Lafayette-FSAE/KiCad-TSI/Circuit_layout.kicad_pcb

## KiCad design Circuit_layout.kicad_pcb (2020-02-18)

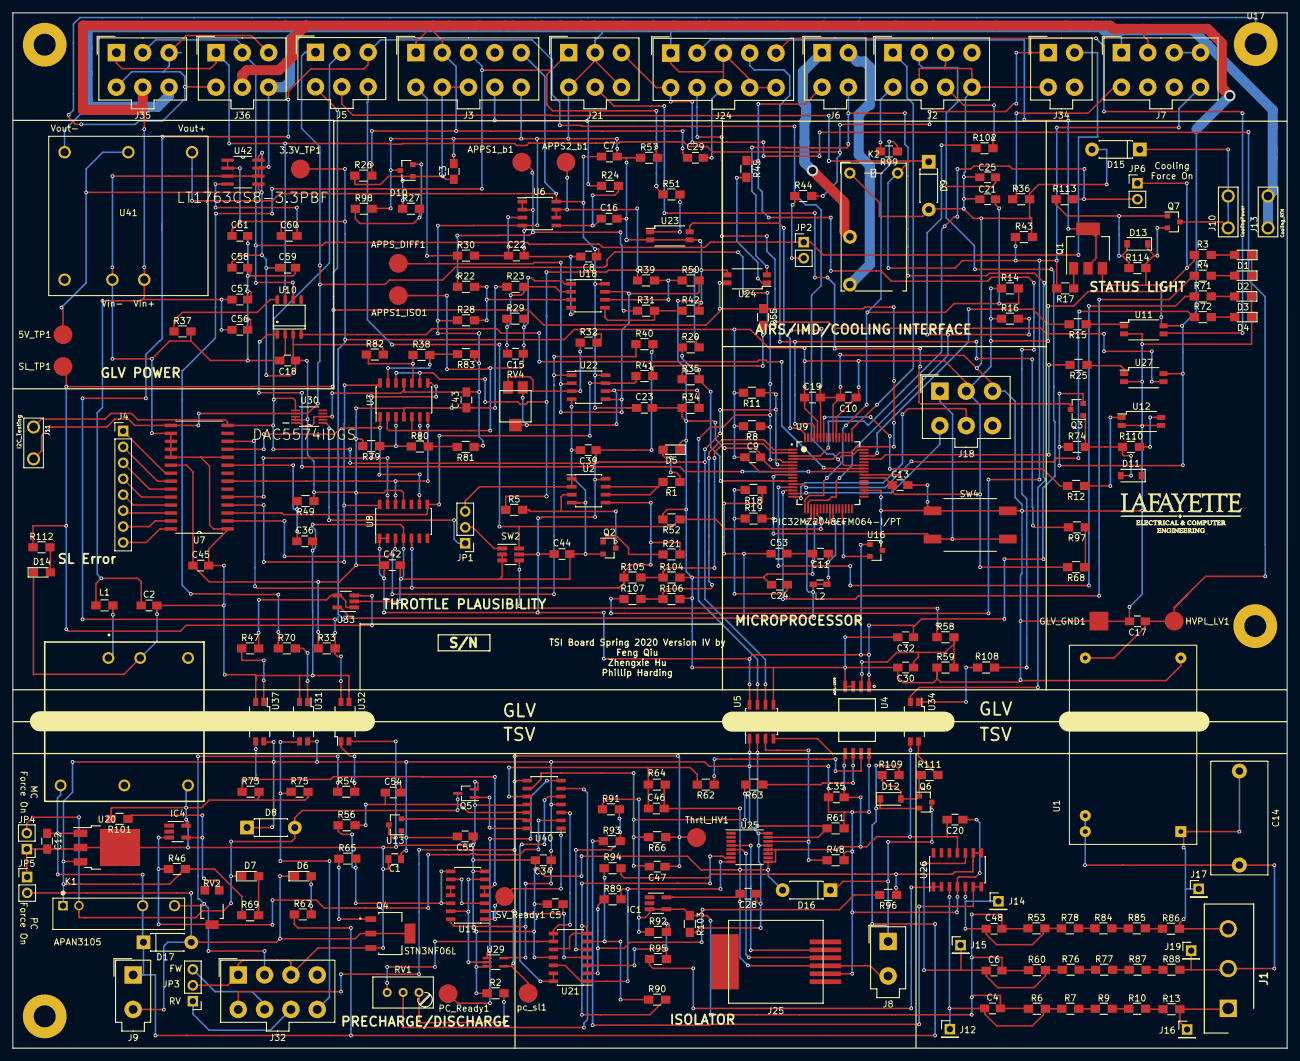
[picture p1: board Circuit_layout.kicad_pcb from above]

Board: 2 copper layers, 203.2 x 165.1 mm, 281 parts (0 on the bottom side), 185 nets.

Parts:
3.3V_TP1: 3.3V_TP; Measurement_Point_Round-SMD-Pad_Big
5V_TP1: 5V_TP; Measurement_Point_Round-SMD-Pad_Big
APPS1_ISO1: APPS1_ISO; Measurement_Point_Round-SMD-Pad_Big
APPS1_b1: APPS1_b; Measurement_Point_Round-SMD-Pad_Big
APPS2_b1: APPS2_b; Measurement_Point_Round-SMD-Pad_Big
APPS_DIFF1: APPS_DIFF; Measurement_Point_Round-SMD-Pad_Big
C1: 0.47u; C_0805
C2, C17: 4.7u; C_0805_HandSoldering
C3, C5, C7, C8, C9, C10, C11, C13, C15, C16, C18, C19, C20, C21, C22, C23, C25, C28, C29, C32, C34, C35, C39, C42, C43, C44, C45, C53, C55, C58: 0.1u; C_0805_HandSoldering
C4, C6, C30, C46, C47, C48: 100p; C_0805_HandSoldering
C12: 0.33u; C_0805_HandSoldering
C14: 1u; C_Rect_L18.0mm_W9.0mm_P15.00mm_FKS3_FKP3
C24: 0.1uF; C_0805_HandSoldering
C36: 33p; C_0805_HandSoldering
C54: 15u; C_0805_HandSoldering
C56, C57, C61: 10u; C_0805_HandSoldering
C59, C60: 1u; C_0805_HandSoldering
D1: Power; LED_0805_HandSoldering
D2: Heartbeat; LED_0805_HandSoldering
D3: Spare/Fault; LED_0805_HandSoldering
D4: Spare; LED_0805_HandSoldering
D5: Throttle_PL; LED_0805_HandSoldering
D6, D7: LED; LED_0805_HandSoldering
D8, D9, D15, D16, D17: 1N4001; D_DO-41_SOD81_P7.62mm_Horizontal
D10: ATL431; SOT-23_D10_special
D11, D12, D13: MMSZ5231B-7-F; D_SOD-123
D14: SL Error; LED_0805_HandSoldering
GLV_GND1: GLV_GND; Measurement_Point_Square-SMD-Pad_Big
HVPL_LV1: TSAL_LV; Measurement_Point_Round-SMD-Pad_Big
IC1, IC4: TS431ILT; SOT-23-5_HandSoldering
J1: TSV; SHDR3W166P0X635_1X3_2032X762X1422P
J2: CoolingSystem; Molex_MiniFit-JR-5556-08A_2x04x4.20mm_Straight
J3: Pedal; Molex_MiniFit-JR-5556-10A_2x05x4.20mm_Straight
J4: Conn_01x08; Pin_Header_Straight_1x08_Pitch2.54mm
J5: Testing Connector; Molex_MiniFit-JR-5556-06A_2x03x4.20mm_Straight
J6: AIRs/SafetyLoop; Molex_MiniFit-JR-5556-04A_2x02x4.20mm_Straight
J7: IMD; Molex_MiniFit-JR-5556-08A_2x04x4.20mm_Straight
J8: DC_Relay; Molex_MiniFit-JR-5556-02A_2x01x4.20mm_Straight
J9: PC_Relay; Molex_MiniFit-JR-5556-02A_2x01x4.20mm_Straight
J10: CoolingPower; TE_1217861-1
J11: I2C_Testing; TE_1217861-1
J12, J14, J15, J16, J17, J19: Conn_01x01; Pin_Header_Straight_1x01_Pitch2.54mm
J13: Cooling_RTN; TE_1217861-1
J18: ICSP; Molex_MiniFit-JR-5556-06A_2x03x4.20mm_Straight
J21: Lights On Car; Molex_MiniFit-JR-5556-06A_2x03x4.20mm_Straight
J24: Cockpit; Molex_MiniFit-JR-5556-10A_2x05x4.20mm_Straight
J25: RJ11; MOLEX_RJ11
J32: Conn_MC; Molex_MiniFit-JR-5556-08A_2x04x4.20mm_Straight
J34: Can_Iso; Molex_MiniFit-JR-5556-04A_2x02x4.20mm_Straight
J35: GLV_In; Molex_MiniFit-JR-5556-06A_2x03x4.20mm_Straight
J36: GLV_Out; Molex_MiniFit-JR-5556-06A_2x03x4.20mm_Straight
JP1, JP3: Jumper_NC_Dual; Pin_Header_Straight_1x03_Pitch2.54mm
JP2, JP6: Jumper; Pin_Header_Straight_1x02_Pitch2.54mm
JP4, JP5: Jumper-Device; Pin_Header_Straight_1x02_Pitch2.54mm
K1: APAN3105; RELAY_APAN3105
K2: G6B-1174P-US-DC24; Relay_SPST_Finder_32.21-x300_special
L1: 2.2uH; L_0805_HandSoldering
L2: 28nH; L_0603_HandSoldering
PC_Ready1: Precharge_Ready; Measurement_Point_Round-SMD-Pad_Big
PS1: THN_30-2415WI; THN_30
Q1: ZVP0545G; SOT-223-3_TabPin2
Q2: MMBF170; SOT-23
Q3, Q6, Q7: ZVP1320F; SOT-23
Q4: STN3NF06L; SOT230P700X180-4N-speical
Q5: SI1302DL-T1-E3; SOT-323_SC-70_Handsoldering_special
R1, R47, R69, R105, R106: 500; R_0805_HandSoldering
R2: 95k; R_0805_HandSoldering
R3, R4, R71, R72, R112: 330; R_0805_HandSoldering
R5, R6, R8, R11, R14, R16, R17, R18, R21, R22, R23, R28, R29, R31, R39, R40, R41, R42, R48, R50, R52, R53, R59, R60, R61, R62, R63, R68, R89, R90, R91, R92, R93, R94, R95, R96, R97, R101, R110, R111, R113: 10k; R_0805_HandSoldering
R7, R9, R10, R13, R76, R77, R78, R84, R85, R86, R87, R88: 150k; R_0805_HandSoldering
R12, R15, R25: 300; R_0805_HandSoldering
R19, R37, R46, R103, R104: 1k; R_0805_HandSoldering
R20: 2k; R_0805_HandSoldering
R24, R30, R57: 100k; R_0805_HandSoldering
R26: 1K; R_0805_HandSoldering
R27, R98: 10K; R_0805_HandSoldering
R32, R34: 4k; R_0805_HandSoldering
R33, R73, R75: 5k; R_0805_HandSoldering
R35, R107: 3k; R_0805_HandSoldering
R36, R43: 2.2k; R_0805_HandSoldering
R38, R80: 9.31k; R_0805_HandSoldering
R44: 120; R_0805_HandSoldering
R45, R51, R54, R55, R67, R70, R108: 2.4k; R_0805_HandSoldering
R49: 3.9K; R_0805_HandSoldering
R56: 56K; R_0805_HandSoldering
R58: 15k; R_0805_HandSoldering
R64, R66: 24.9k; R_0805_HandSoldering
R65: 5K; R_0805_HandSoldering
R74, R109, R114: 1M; R_0805_HandSoldering
R79, R81, R82, R83: 499; R_0805_HandSoldering
R99, R102: 1.6k; R_0805_HandSoldering
RV1: 3296W-1-103LF; Potentiometer_Trimmer_Bourns_3296W
RV2: POT_TRIM; 23BR10KLFTR
RV4: 1k; trim_pot
SL_TP1: SL_TP; Measurement_Point_Round-SMD-Pad_Big
SW2: TS5A3159-Q1; SOT-23-6_Handsoldering
SW4: SW_PUSH; SW_RACON_8
TSV_Ready1: TSV_Ready; Measurement_Point_Round-SMD-Pad_Big
Thrtl_HV1: Throttle_HV; Measurement_Point_Round-SMD-Pad_Big
U1: RDE03110S12; RDE03110S12_new
U2: MCP6002; SOIC-8_3.9x4.9mm_Pitch1.27mm
U3, U21, U26, U40: MCP6004; SOIC-14_3.9x8.7mm_Pitch1.27mm
U4: ACPL-C870; SOIC127P1150X360-8N
U5: SI8600AB-B-IS; SOIC-8_3.9x4.9mm_Pitch1.27mm
U6, U18: TS912; SOIC-8_3.9x4.9mm_Pitch1.27mm
U7: MCP23016; SOIC127P1030X265-28N
U8: 74ACT11030; SOIC-14_3.9x8.7mm_Pitch1.27mm
U9: PIC32MZ2048EFM064-I/PT; QFP50P1200X1200X120-64N
U10: MCP2551-I/SN; SO-8
U11, U12, U23, U24, U27, U31, U32, U34, U37: TLP293; SOP-4_4.4x2.8mm_Pitch1.27mm
U13: REF3033; SOT-23
U14, U15, U28: Mounting_hole; MountingHole_3.5mm_Pad
U16: MCP9700AT-H/TT; SOT-23
U17: Chassis Ground; MountingHole_3.5mm_Pad
U19: 74HC00; SOIC-14_3.9x8.7mm_Pitch1.27mm
U20: MC7805BDTRKG; TO-252-3_TabPin4
U22: TS372; SOIC-8_3.9x4.9mm_Pitch1.27mm
U25: NCD9830DBR2G; TSSOP-16_4.4x5mm_Pitch0.65mm
U29: SN74LVC1G08DCKR; SOT-353_SC-70-5_Handsoldering
U30: DAC5574IDGS; SOP50P490X110-10N
U33: MCP6001; SOT-23-5_HandSoldering
U41: PDQ10-Q24-D5-D; PDQ_DCDC
U42: LT1763CS8-3.3PBF; SOIC127P600X175-8N
pc_sl1: pc_sl; Measurement_Point_Round-SMD-Pad_Big

Connections:
/+1.24Vref: IC4.3, R46.1, RV2.2, U40.2
/+3.3V: 3.3V_TP1.1, C9.1, C10.1, C11.1, C13.1, C19.1, C53.1, C60.1, C61.1, J18.2, JP6.1, L2.1, L2.2, R3.1, R8.2, R11.2, R14.1, R16.1, R18.1, R68.2, U9.8, U9.19, U9.26, U9.39, U9.54, U9.60, U33.5, U42.1, U42.2
/+5HV: C1.1, C5.1, C20.1, C28.1, C34.1, C35.1, C55.2, D8.1, J25.5, K1.A1, R46.2, R48.2, R61.2, R69.1, R103.2, U4.8, U5.1, U13.1, U19.14, U20.3, U21.4, U25.13, U25.16, U26.4, U29.5, U31.4, U37.4, U40.4
/+5V: 5V_TP1.1, C18.1, C32.1, C39.1, C42.1, C43.1, C44.1, C45.1, C58.1, C59.1, J2.2, R23.1, R33.1, R40.2, R41.2, R49.1, R55.2, R79.2, R82.2, SW2.5, U2.8, U3.4, U4.1, U5.8, U7.20, U8.1, U8.2, U8.11, U10.3, U16.1, U30.8, U30.9, U41.4, U42.5, U42.8
/+10V: C7.1, C8.1, C23.1, J3.5, R32.2, U6.8, U18.8, U22.8, U41.3
/+24V: C2.1, C29.1, C56.1, C57.1, D11.1, D13.1, J3.1, J3.2, J7.2, J35.5, J36.5, L1.1, Q1.3, Q3.2, Q7.2, R26.2, R74.1, R114.2, U11.4, U27.4, U41.1
/AIRs+: J6.3, R45.1, R108.1
/AIRs-: J6.4, U24.2, U34.2
/APPS: R20.1, R35.2, U9.11
/BP: J3.3, J21.1, R51.1, R57.2, R70.1
/BP_RTN: C2.2, C3.2, C7.2, C8.2, C9.2, C10.2, C11.2, C13.2, C16.2, C17.2, C18.2, C19.2, C21.2, C22.2, C23.2, C24.2, C25.2, C29.2, C30.2, C32.2, C36.2, C39.2, C42.2, C43.2, C44.2, C45.2, C53.2, C56.2, C57.2, C58.2, C59.2, C61.2, D1.1, D2.1, D3.1, D4.1, D5.1, D9.2, D10.2, D14.1, D15.2, GLV_GND1.1, J2.3, J2.6, J2.8, J3.10, J7.1, J7.3, J7.4, J13.1, J13.2, J18.3, J21.2, J21.4, J21.6, J24.1, J24.3, J24.8, J24.9, J24.10, J34.3, J35.6, J36.6, K2.A2, PS1.2, Q2.2, R28.1, R34.1, R35.1, R36.2, R37.2, R42.2, R43.2, R52.2, R57.1, R59.1, R81.1, R83.1, R98.2, R104.2, R106.2, SW2.2, SW2.3, SW4.2, U1.12, U2.4, U3.11, U4.3, U4.4, U5.5, U6.4, U7.1, U7.10, U7.16, U7.17, U7.18, U7.19, U8.4, U9.7, U9.20, U9.25, U9.34, U9.35, U9.40, U9.55, U9.59, U10.2, U11.2, U12.2, U12.3, U16.3, U18.4, U22.4, U23.2, U23.3, U24.3, U27.2, U30.3, U30.10, U31.2, U32.3, U33.2, U37.2, U41.2, U41.5, U42.3, U42.6, U42.7
/BP_uC: U9.64, U23.4
/CANRX: U9.42, U10.4
/CANTX: U9.41, U10.1
/CH_gnd: J35.3, J35.4, J36.3, J36.4, U17.1
/CoolTemp_1: C21.1, R14.2, R99.1, U9.17
/CoolTemp_2: C25.1, R16.2, R102.1, U9.18
/CoolTemp_In_1: J2.5, R99.2
/CoolTemp_In_2: J2.7, R102.2
/Cooling_CTRL: JP6.2, R113.2, U9.3
/Cooling_power: D15.1, J10.1, J10.2, Q7.3
/D_LED_CTRL: R15.2, U9.46
/Drive_BTN: J24.4, R97.2, U9.61
/FlowRate: J2.1, U9.49
/GLV Interface/CAN_H: J34.1, J35.1, J36.1, R44.2, U10.7
/GLV Interface/CAN_L: J34.2, J35.2, J36.2, JP2.1, U10.6
/GLV Interface/IMD_MHS: J7.5, R36.1
/GLV Interface/SL1_In: J6.1, K2.11
/GLV Interface/SL1_Out: J6.2, K2.14
/HV+: C14.1, J1.3, J17.1, R86.2, U1.1
/HV-: C14.2, J1.2, J19.1, R88.2, U1.23, U1.24
/Heartbeat: R4.1, U9.14
/I/O_Ground: C1.2, C5.2, C12.2, C20.2, C28.2, C34.2, C35.2, C46.2, C54.2, C55.1, D16.2, IC1.5, IC4.5, J8.2, J25.4, J32.1, J32.3, JP3.2, JP4.1, JP5.1, PS1.5, Q4.3, Q5.3, R2.1, R64.1, R73.2, R75.2, R101.2, U4.5, U5.4, U13.3, U19.7, U20.2, U20.4, U21.11, U25.9, U25.11, U25.12, U26.11, U29.3, U32.2, U34.3, U40.11
/IMD_Status: D9.1, J5.5, J7.8, K2.A1, R17.2, R43.1, R107.1
/IMD_Status_3.3: R106.1, R107.2, U9.1
/Isolators/A1_HV: J25.2, U25.4
/Isolators/A2_HV: J25.3, U25.5
/Isolators/DiffAmpRef: C4.2, C6.2, C48.2, IC1.3, IC1.4, R6.1, R53.1, R60.1, R91.1, R92.1, R103.1
/Isolators/MC+: J1.1, J16.1, R13.2
/Isolators/SCL_HV: R48.1, U5.3, U25.14
/Isolators/SDA_HV: R61.1, U5.2, U25.15
/MC_V: R89.2, U21.1, U21.12, U25.8
/PC_ready: J5.3, R33.2, U9.43, U9.48, U32.4
/PGEC: J18.4, U9.15
/PGED: J18.5, U9.16
/Pre-Charge/+3.3Vref: U13.2, U40.13
/Pre-Charge/+24HV: C12.1, D12.1, D17.1, J9.1, K1.14, PS1.3, Q6.2, R67.1, R109.2, U20.1
/Pre-Charge/BP_HV: J32.8, R75.1, U31.3
/Pre-Charge/DC_Relay+: D16.1, J8.1, Q6.3
/Pre-Charge/IGNI_VCC: J32.2, K1.11, R54.1
/Pre-Charge/PC_Relay-: D6.1, D17.2, J9.2, JP5.2, Q4.1, Q4.4
/Pre-Charge/Precharge_Ready: PC_Ready1.1, U29.1, U40.7
/Pre-Charge/Safety_Loop_HV: R73.1, U19.4, U19.5, U37.3
/Pre-Charge/TSV_Ready: TSV_Ready1.1, U19.1, U40.1
/Pre-Charge/pc_and_sl_ready: U19.2, U29.4, pc_sl1.1
/RTDS_CTRL: R12.2, U9.58
/SCL: J5.2, J11.1, R11.1, U5.6, U7.14, U9.6, U30.6
/SDA: J5.1, J11.2, R8.1, U5.7, U7.15, U9.5, U30.7
/SPARE_LED_CTRL: R25.2, U9.45
/Safety_Loop: J5.4, R55.1, R112.1, SL_TP1.1, U9.4, U24.4, U33.3
/Spare_Blue: R72.1, U9.12
/Spare_Red: R71.1, U9.13
/Status Lights/Drive_LED: J24.5, U11.3
/Status Lights/IMD_Fault_LED: J24.2, Q1.2
/Status Lights/RTDS: J21.5, Q3.3
/Status Lights/SPARE_LED: J24.7, U27.3
/Status Lights/TSAL_1: C17.1, HVPL_LV1.1, J21.3, J24.6, U1.13
/TSV_V: R90.2, U21.7, U21.10, U25.7
/ThrottlePlausibility/5v_ref: C3.1, D10.3, J3.7, J3.8, R26.1, R27.1
/ThrottlePlausibility/APPS1: J3.6, R30.1
/ThrottlePlausibility/APPS1_ISO: APPS1_ISO1.1, C15.1, R29.2, U3.2, U3.5, U18.1
/ThrottlePlausibility/APPS1_b: APPS1_b1.1, R22.1, R31.1, U6.1, U6.2
/ThrottlePlausibility/APPS2: J3.9, R24.1
/ThrottlePlausibility/APPS2_b: APPS2_b1.1, R5.1, R20.2, R39.1, U3.9, U3.12, U6.6, U6.7
/ThrottlePlausibility/Pedal_Out: JP1.3, U2.1, U2.2
/Throttle_HV: C47.1, J32.5, R66.1, Thrtl_HV1.1, U40.8
/Throttle_LV: R58.1, SW2.4
/Throttle_PL: R21.2, R105.1, U2.5, U7.12, U8.5
/Throttle_PL_3.3: R104.1, R105.2, U9.2
/Throttle_SEL: J5.6, R52.1, SW2.6, U9.21
/~MCLR: J18.1, R19.2, SW4.1, U9.9
unnamed: APPS_DIFF1.1, R50.2, U18.7, U22.2, U22.5
unnamed: C4.1, J12.1, R6.2, R7.1, U26.3
unnamed: C6.1, J15.1, R60.2, R76.1, U26.10
unnamed: C15.2, R23.2, R29.1, U18.2
unnamed: C16.1, R24.2, U6.5
unnamed: C22.1, R30.2, U6.3
unnamed: C24.1, R18.2, R19.1
unnamed: C30.1, R58.2, R59.2, U4.2
unnamed: C36.1, R49.2, U7.9
unnamed: C46.1, R62.2, R64.2, U40.10
unnamed: C47.2, R63.2, R66.2, U40.9
unnamed: C48.1, J14.1, R53.2, R78.1, U26.5
unnamed: C54.1, R56.2, U40.12
unnamed: C60.2, U42.4
unnamed: D1.2, R3.2
unnamed: D2.2, R4.2
unnamed: D3.2, R71.2
unnamed: D4.2, R72.2
unnamed: D5.2, R1.1
unnamed: D6.2, R67.2
unnamed: D7.1, D8.2, JP4.2, K1.A2, Q5.1
unnamed: D7.2, R69.2
unnamed: D10.1, R27.2, R98.1
unnamed: D11.2, Q3.1, R74.2, R110.1
unnamed: D12.2, Q6.1, R109.1, R111.1
unnamed: D13.2, Q7.1, R113.1, R114.1
unnamed: D14.2, R112.2
unnamed: IC4.4, R101.1, RV2.1
unnamed: J4.1, U7.21
unnamed: J4.2, U7.22
unnamed: J4.3, U7.23
unnamed: J4.4, U7.24
unnamed: J4.5, U7.25
unnamed: J4.6, U7.26
unnamed: J4.7, U7.27
unnamed: J4.8, U7.28
unnamed: J32.6, JP3.3
unnamed: J32.7, JP3.1
unnamed: JP1.1, U30.1
unnamed: JP1.2, SW2.1
unnamed: JP2.2, R44.1
unnamed: L1.2, PS1.1
unnamed: Q1.1, R17.1
unnamed: Q2.1, R21.1
unnamed: Q2.3, R5.2, U2.3
unnamed: Q4.2, R65.1
unnamed: Q5.2, U40.14
unnamed: R1.2, U2.6, U2.7
unnamed: R2.2, RV1.1
unnamed: R7.2, R9.1
unnamed: R9.2, R10.1
unnamed: R10.2, R13.1
unnamed: R12.1, U12.1
unnamed: R15.1, U11.1
unnamed: R22.2, R28.2, U18.3
unnamed: R25.1, U27.1
unnamed: R31.2, R42.1, U18.5
unnamed: R32.1, RV4.1, U22.3
unnamed: R34.2, RV4.2, RV4.3, U22.6
unnamed: R37.1, U10.8
unnamed: R38.1, R82.1, U3.10
unnamed: R38.2, R83.2, U3.13
unnamed: R39.2, R50.1, U18.6
unnamed: R40.1, U7.2, U8.3, U22.1
unnamed: R41.1, U7.3, U8.8, U22.7
unnamed: R45.2, U24.1
unnamed: R47.1, U37.1
unnamed: R47.2, U33.1, U33.4
unnamed: R51.2, U23.1
unnamed: R54.2, U32.1
unnamed: R56.1, R65.2, U19.8, U19.12
unnamed: R62.1, U4.7
unnamed: R63.1, U4.6
unnamed: R68.1, R97.1
unnamed: R70.2, U31.1
unnamed: R76.2, R77.1
unnamed: R77.2, R87.1
unnamed: R78.2, R84.1
unnamed: R79.1, R80.1, U3.3
unnamed: R80.2, R81.2, U3.6
unnamed: R84.2, R85.1
unnamed: R85.2, R86.1
unnamed: R87.2, R88.1
unnamed: R89.1, R96.2, U21.2
unnamed: R90.1, R94.2, U21.6
unnamed: R91.2, R93.2, U21.5
unnamed: R92.2, R95.2, U21.3
unnamed: R93.1, U26.6, U26.7
unnamed: R94.1, R96.1, U26.8, U26.9
unnamed: R95.1, U26.1, U26.2
unnamed: R108.2, U34.1
unnamed: R110.2, U12.4
unnamed: R111.2, U34.4
unnamed: RV1.2, U40.6
unnamed: RV1.3, U21.8, U21.9, U40.3
unnamed: U3.1, U7.11, U8.9
unnamed: U3.7, U7.7, U8.12
unnamed: U3.8, U7.5, U8.13
unnamed: U3.14, U7.4, U8.14
unnamed: U9.29, U16.2
unnamed: U19.3, U19.9
unnamed: U19.10, U19.11
unnamed: U19.6, U19.13, U29.2
unnamed: U21.13, U21.14, U40.5
