Lafayette-FSAE/KiCad-TSI/(commit log)

2019-09-18 back up from 2018
    [Circuit_layout.kicad_pcb, Circuit_layout.sch, GLV_tcvr.sch, Pre-Charge.sch, StatusLights.sch, ThrottlePlausibility.sch, isolators.sch]
2019-09-18 kicad mod backup
2019-09-23 F2018 version 1 before review
    [Circuit_layout.kicad_pcb]
2019-09-24 backup; Add cooling power connector
    [Circuit_layout.kicad_pcb, Circuit_layout.sch, GLV_tcvr.sch, Pre-Charge.sch, StatusLights.sch]
2019-09-29 modify cooling power
    relay added for cooling power control; reroute signals to PIC32 analog input
    [Circuit_layout.kicad_pcb, Circuit_layout.sch, GLV_tcvr.sch, Pre-Charge.sch, StatusLights.sch, ThrottlePlausibility.sch, isolators.sch]
2019-10-03 Version 3 ready for FREEDFM check
    [Circuit_layout.kicad_pcb, Circuit_layout.sch, GLV_tcvr.sch, Pre-Charge.sch]
2019-10-07 Additional spade connector for Cooling_RTN
    Ready for fabrication
    [Circuit_layout.kicad_pcb, Circuit_layout.sch, Pre-Charge.sch]
2019-10-17 fixing Vref on diff amps
    [Circuit_layout.kicad_pcb, Circuit_layout.sch, GLV_tcvr.sch, Pre-Charge.sch, isolators.sch]
2020-02-18 TSI v4.1
    [Circuit_layout.kicad_pcb, Circuit_layout.sch, GLV_tcvr.sch, Pre-Charge.sch, StatusLights.sch, isolators.sch]
